65roadster/km-optical-theremin/README.md

# km-optical-theremin
 Learn to SMT Class
