65roadster/km-optical-theremin/misc/theremin-v1-bom.xlsx

Qty | Designator | Item | Marking | Cost Ea | Ext Cost
1 | - | PCB | - | $1.00 | $1.00
1 | - | 9V Battery | - | $1.50 | $1.50
1 | - | 9V Battery Clip | -
6 | R1, R2, R4 | 1k resistor, 1206 | 102 | $0.01 | $0.06
2 | R3, R5 | Trimpot, 100k | - | $0.13 | $0.26 | https://www.aliexpress.com/item/32962861159.html?spm=a2g0s.9042311.0.0.567a4c4dAAs0Fj
1 | R6 | LDR Cell, KM store | - | $0.02 | $0.02
2 | R7 | 100 ohm resistor, 1206 | - | $0.13 | $0.26 | https://www.aliexpress.com/item/32962861159.html?spm=a2g0s.9042311.0.0.567a4c4dAAs0Fj
1 | D1 | LEDs, 0805 | - | $0.02 | $0.02 | https://www.aliexpress.com/item/32602493357.html?spm=a2g0s.9042311.0.0.567a4c4dAAs0Fj
2 | C2, C4 | Cap, 0.01uF, 0603 | - | $0.01 | $0.02 | https://www.aliexpress.com/item/4000834418510.html?spm=a2g0s.9042311.0.0.567a4c4dAAs0Fj
4 | C3, C5 | Cap, 0.1uF, 0805 | - | $0.01 | $0.04 | https://www.aliexpress.com/item/4000834418510.html?spm=a2g0s.9042311.0.0.567a4c4dAAs0Fj
2 | C1 | Cap, 10uF, 1206 | - | $0.02 | $0.04 | https://www.aliexpress.com/item/32373712363.html?spm=a2g0s.9042311.0.0.567a4c4dAAs0Fj
2 | U1, U2 | NE555 Timer, SOIC-8 | NE555 | $0.02 | $0.05 | https://www.aliexpress.com/item/33022646609.html?spm=a2g0s.9042311.0.0.567a4c4dAAs0Fj
1 | - | 40mm speaker | - | $1.95 | $1.95 | https://www.amazon.com/gp/product/B01BB4YMCU/ref=ppx_yo_dt_b_search_asin_image?ie=UTF8&psc=1
1 | SW1 | SPDT slide switch, KM store | - | $0.00 | $0.00 | Ray's stock
1 |  | Solder, 0.015" | - | $0.00 | $0.00 | Ray's stock
1 |  | Solder wick | - | $0.00 | $0.00 | Ray's stock
1 |  | Extra practice PCB | - | $0.00 | $0.00 | Ray's stock
1 |  | Extra practice PCB components | - | $0.00 | $0.00 | Ray's stock
1 |  | Extra practice SMT parts | - | $0.00 | $0.00 | Ray's stock
 |  | Total |  |  | $5.22
