65roadster/km-optical-theremin/kicad/SMT-Theremin-v1.kicad_pcb

## KiCad design kicad/SMT-Theremin-v1.kicad_pcb (2020-06-15)

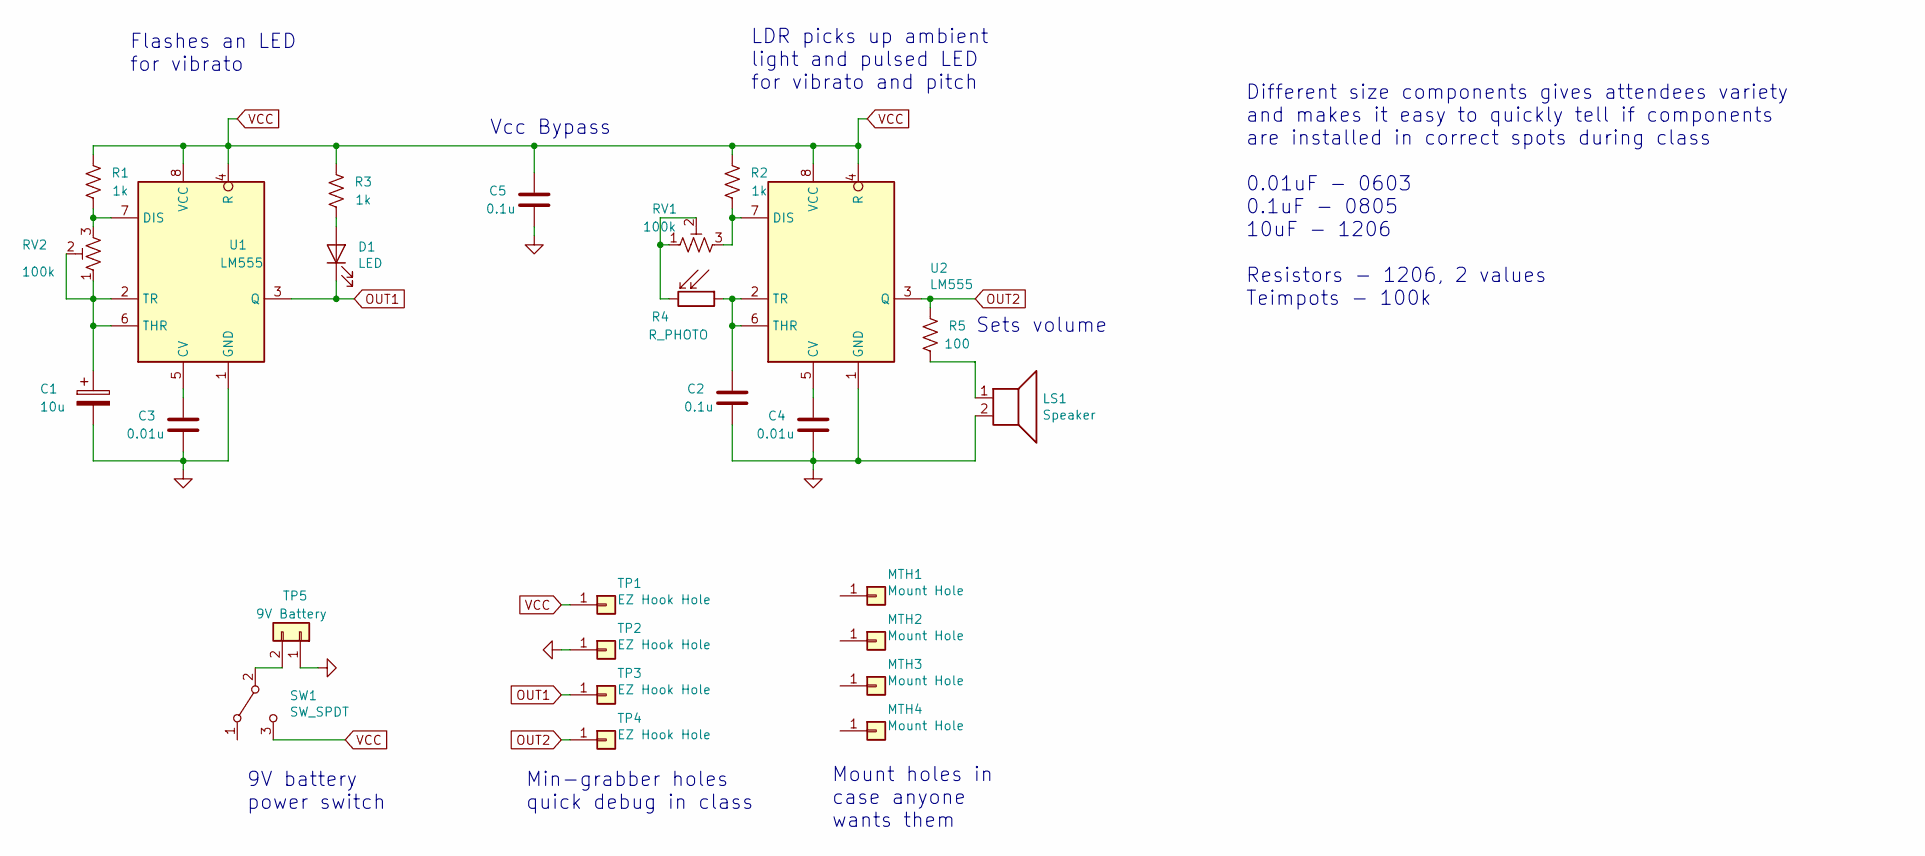
[picture p1: schematic SMT-Theremin-v1.sch]

Parts:
C1: 10u; C_1206_HandSoldering
C2, C5: 0.1u; C_0805_HandSoldering
C3, C4: 0.01u; C_0603_HandSoldering
D1: LED; D_0805_HandSoldering
LS1: Speaker; Speaker-40mm
MTH1, MTH2, MTH3, MTH4: Mount Hole; Mount-Hole-#4
R1, R2, R3: 1k; R_1206_HandSoldering
R4: R_PHOTO; R_LDR_5.1x4.3mm_P3.4mm_Vertical
R5: 100; R_1206_HandSoldering
RV1, RV2: 100k; Potentiometer_Vishay_TS53YJ_Vertical
SW1: SW_SPDT; KM-SPDT-Slide
TP1, TP2, TP3, TP4: EZ Hook Hole; TP-Minigrabber-Edge-Via
TP5: 9V Battery; PinHeader_1x02_P2.54mm_Vertical
U1, U2: LM555; SOIC-8_3.9x4.9mm_P1.27mm

Connections:
GND: C1.2, C2.1, C3.1, C4.1, C5.1, LS1.2, TP2.1, TP5.1, U1.1 (GND), U2.1 (GND)
unnamed: C1.1, RV2.1, RV2.2, U1.2 (TR), U1.6 (THR)
unnamed: C2.2, R4.1, U2.2 (TR), U2.6 (THR)
unnamed: C3.2, U1.5 (CV)
unnamed: C4.2, U2.5 (CV)
unnamed: D1.2 (A), R3.1
unnamed: LS1.1, R5.1
unnamed: R1.1, RV2.3, U1.7 (DIS)
unnamed: R2.1, RV1.3, U2.7 (DIS)
unnamed: R4.2, RV1.1, RV1.2
unnamed: SW1.2 (B), TP5.2
OUT1: D1.1 (K), TP3.1, U1.3 (Q)
OUT2: R5.2, TP4.1, U2.3 (Q)
VCC: C5.2, R1.2, R2.2, R3.2, SW1.3 (C), TP1.1, U1.4 (R), U1.8 (VCC), U2.4 (R), U2.8 (VCC)

Notes on the sheet:
9V battery power switch
Min-grabber holes quick debug in class
Mount holes in case anyone wants them
Flashes an LED for vibrato
LDR picks up ambient light and pulsed LED for vibrato and pitch
Different size components gives attendees variety and makes it easy to quickly tell if components are installed in correct spots during class 0.01uF - 0603 0.1uF - 0805 10uF - 1206 Resistors - 1206, 2 values Teimpots - 100k
Vcc Bypass
Sets volume

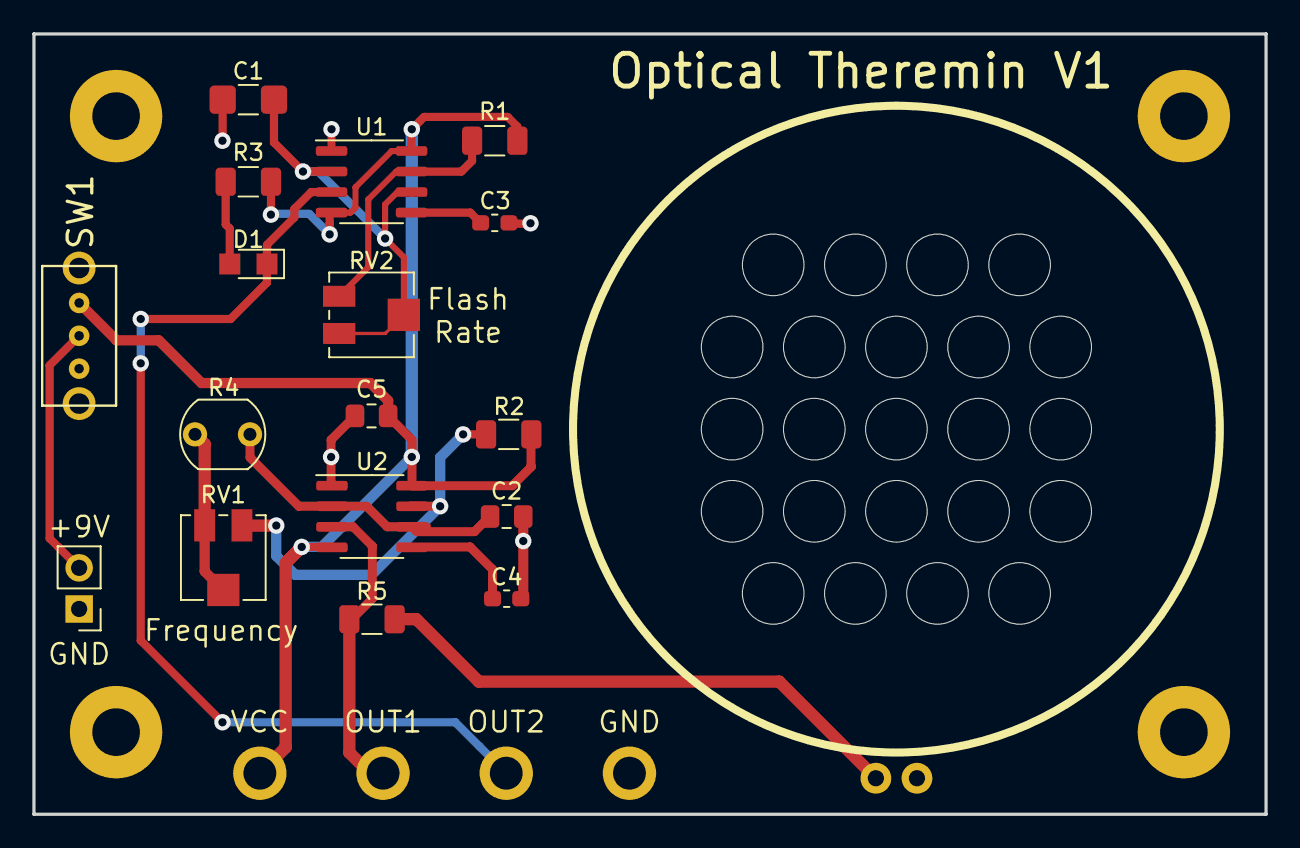
[picture p2: board SMT-Theremin-v1.kicad_pcb from above]

Board: 2 copper layers, 76.2 x 48.3 mm, 26 parts (0 on the bottom side), 14 nets.
