65roadster/km-optical-theremin/(commit log)

2020-06-16 FInalized schematic and layout, submit for order
    [SMT-Theremin-v1-B_Cu.gbr, SMT-Theremin-v1-B_Mask.gbr, SMT-Theremin-v1-Edge_Cuts.gbr, SMT-Theremin-v1-F_Cu.gbr, SMT-Theremin-v1-F_Mask.gbr, SMT-Theremin-v1-F_SilkS.gbr, SMT-Theremin-v1-NPTH.drl, SMT-Theremin-v1-PTH.drl]
2020-06-16 Layout tweaks for order
    [SMT-Theremin-v1-B_Cu.gbr, SMT-Theremin-v1-B_Mask.gbr, SMT-Theremin-v1-Edge_Cuts.gbr, SMT-Theremin-v1-F_Cu.gbr, SMT-Theremin-v1-F_Mask.gbr, SMT-Theremin-v1-F_SilkS.gbr, SMT-Theremin-v1-NPTH.drl, SMT-Theremin-v1-PTH.drl]
